dcbatipm/spine_smart/hardware/case-v3/README.txt

Spine Smart v3: корпус для базового этапа I

Для печати сначала экспортируйте bottom_v3.scad и lid_v3.scad в STL с помощью OpenSCAD.
Команды приведены в корневом README.md.

Размер корпуса в сборе: 70 x 58 x 9.6 мм.
Общий размер с проушинами: 80 x 58 x 9.6 мм.
Основание: 8.3 мм; крышка: 1.3 мм; внутренняя высота: 7.0 мм.

Номинальные размеры компонентов:
аккумулятор 25 x 35 x 6 мм,
TP4056 17.5 x 28 x 4 мм,
ESP32-C3 18 x 22.5 x 3.8 мм,
MPU-6050 16 x 21 x 2.8 мм,
вибромотор диаметром 10 мм, высотой 3 мм.

Что изменено:
- платы размещены рядом без наложений, с полной высотой макетов;
- аккумулятор с тонкой крепёжной лентой 0.2 мм имеет 0.8 мм запаса до крышки;
- четыре съёмные защёлки перенесены к свободным торцам;
- добавлена выемка под ноготь;
- проушины имеют сквозные замкнутые отверстия 26 x 2.8 мм;
- есть монтажные площадки и ограничители для плат, кольцо для вибромотора;
- есть отверстия под зарядку, USB ESP32 и ползунок выключателя;
- есть площадка для выключателя и мелких деталей, зазоры вокруг перегородки для проводов.

Как печатать:
1. Загрузите оба STL в слайсер. Масштаб 100%, единицы мм.
2. Корпус — дном на столе, открытой полостью вверх.
3. Крышка уже ориентирована: наружной плоскостью на столе, защёлками вверх.
4. Материал PETG. Сопло 0.4 мм, первый пробный экземпляр слоем 0.12-0.16 мм.
   Температуры и скорость возьмите из профиля своего принтера и пластика.
5. Посмотрите слои: все четыре язычка крышки должны печататься целиком.
   Оба STL — замкнутые цельные тела, но параметры слайсинга здесь не проверены.
6. После охлаждения снимите детали и примерьте пустую крышку.
   Открывайте от выемки под ноготь, освобождая защёлки постепенно.
7. Примерьте платы и аккумулятор без подключения питания; проверьте доступ
   к разъёмам и отсутствие давления на батарею до установки электроники.

Монтаж:
- Без вертикальных гребёнок и DuPont, согласно компоновке.
- Платы, датчик и мотор крепить тонкой монтажной лентой. Площадки под платы
  подняты на 0.6 мм, в макете заложено ещё 0.2 мм под ленту.
- Не выдумывались позиции винтовых отверстий покупных плат: их размеры не даны.
- Выключатель: выделенное место 12 x 6 x 5 мм — допущение, а не подтверждённый
  размер SS12D00. Проверьте конкретный переключатель до окончательной сборки.
- Центры и высоты USB-портов не измерены. Вырезы 12 x 5 мм сделаны
  предварительно; их совмещение и ход ползунка нужно проверить на реальных деталях.
  В SCAD есть параметры charge_x, esp_usb_x, usb_z, switch_slot_w и switch_z.

Проверено программно:
- OpenSCAD успешно построил оба STL.
- Каждая деталь состоит из одного связного замкнутого тела.
- Пересечения корпуса с макетами компонентов отсутствуют.
- Пересечение установленной крышки с корпусом отсутствует.
- Номинальные компоненты не пересекаются между собой и не касаются крышки.

Ограничение: это проверенный геометрически прототип под номинальные размеры компонентов.
Реальная печать, усилие защёлок, допуски принтера, прочность проушин и посадка
купленных деталей не проверены. Первый комплект нужен для примерки.
Для этапа II с N20 этот корпус не рассчитан.
