dcbatipm/spine_smart/docs/STATUS.md

# Состояние проекта — 26 октября 2026

Текущая прошивка v0.1.1: ESP32-C3 SuperMini, поддержка MPU6050 и MPU6500. На проверенном устройстве обнаружен MPU6500 (WHO_AM_I 0x70). Корпус — v3.

Подтверждены связь с датчиком, сохранение калибровки и поправки гироскопа после программного перезапуска, базовые переходы UPRIGHT → TILT_PENDING → SLOUCH и возврат UPRIGHT при выпрямлении. Мотор в этих проверках был выключен. Порог по умолчанию 15°, задержка 10 с, интервал предупреждений не менее 30 с. Точная задержка физически не измерена.

26 октября повторно прошли тесты логики на хосте (11/11), сборка обеих деталей в OpenSCAD 2021.01 и проверка геометрии: каждая деталь замкнута и связна, номинальные габариты компонентов не пересекаются.

Полная сборка прошивки в облаке успешно выполнена Arduino CLI 1.3.1 с Arduino-ESP32 3.3.2 для ESP32C3 Dev Module, USB CDC On Boot, 4 MB flash, Huge APP. Размер приложения 697016 байт (22% от 3145728), глобальные переменные 24800 байт (7% от 327680). Проверенные исходники соответствуют коммиту 53e82f1. Запись на устройство не выполнялась.

Следующие физические проверки: холодный запуск, посадка в напечатанном корпусе, схема моторного ключа и вибрация, BLE с телефоном, аккумулятор и зарядка, ложные срабатывания при обычной активности. После изменения крепления или человека повторить калибровку.

Мотор подключается через внешний транзисторный ключ с проверенной распиновкой и защитным диодом, не напрямую к GPIO. Перед проверкой мотора сверить питание. Облако не имеет прямого доступа к USB-плате на ноутбуке.

Публичный репозиторий содержит исходники и документацию. Частная переписка, телеметрия, дампы памяти, исходные архивы и история частного рабочего каталога сюда не включены.
