dcbatipm/spine_smart/bom/BOM.md

# Bill of Materials (BOM) — Спецификация компонентов
**Проект:** Носимое устройство для поддержания правильной осанки (dfp2026-b01-508)

---

## 1. Этап I: Электроника базового мониторинга и тактильного отклика

| № | Позиция / Компонент | Описание и характеристики | Кол-во | Назначение |
|---|---|---|---|---|
| 1 | **ESP32-C3 SuperMini** | МК 32-bit RISC-V, 160 МГц, встроенный 2.4 GHz Wi-Fi / BLE 5.0 | 1 шт. | Сбор данных, BLE-стек, логика FSM |
| 2 | **MPU-6050 (GY-521)** | 6-осевой IMU (акселерометр + гироскоп), шина I2C | 1 шт. | Измерение наклона грудного отдела позвоночника |
| 3 | **Вибромотор 1027** | Плоский дисковый ERM вибромотор (диаметр 10 мм, 3 В) | 2 шт. | Вибротактильное напоминание (1 шт. запас) |
| 4 | **Транзистор 2N2222 / SS8050** | Биполярный NPN-транзистор (SOT-23 / TO-92) | 2 шт. | Силовой ключ управления вибромотором от GPIO |
| 5 | **Диод 1N4148** | Импульсный диод (обратный диод для защиты от индуктивных выбросов) | 2 шт. | Защита транзистора при отключении мотора |
| 6 | **Резисторы 1 кОм и 10 кОм** | Резисторы 0.125 Вт / SMD 0805 | по 2 шт.| Базовое ограничение и подтяжка к земле (pull-down) |
| 7 | **Li-Pol аккумулятор 3.7 В** | Ёмкость 500–650 мА·ч (типоразмер 602535 / 702535) с платой защиты | 1 шт. | Автономное питание нательного модуля |
| 8 | **Модуль заряда TP4056 Type-C** | Контроллер заряда с цепью защиты аккумулятора | 1 шт. | Зарядка АКБ от стандартного разъёма Type-C |
| 9 | **Ползунковый переключатель SS12D00** | Миниатюрный тумблер включения питания (ON/OFF) | 1 шт. | Разрыв цепи питания аккумулятора |

---

## 2. Корпус, швейная оснастка и механика (Этап I)

| № | Позиция / Материал | Описание и характеристики | Кол-во | Назначение |
|---|---|---|---|---|
| 10 | **Ременная стропа 25 мм** | Плотная полипропиленовая / нейлоновая лента | 2.5 м | Формирование плечевой петли-«восьмёрки» |
| 11 | **Пряжка двухщелевая (ladder-lock) 25 мм** | Пластиковая фурнитура для ручной подгонки длины | 2 шт. | Первичная регулировка посадки под рост и плечи |
| 12 | **Фастекс (защёлка) 25 мм** | Быстроразъёмный пластиковый замок | 1 шт. | Удобное надевание/снятие и экстренный сброс |
| 13 | **Филамент PETG / PLA+** | Износостойкий пластик для 3D-печати | ~150 г | Печать корпуса межлопаточного блока и крышки |
| 14 | **Винты и вплавляемые резьбовые втулки M2 / M2.5** | Латунные втулки + винты потай/полукруг | 4 комплекта | Разборная фиксация крышки нательного корпуса |

---

## 3. Этап II: Модуль активной механической коррекции (расширение)

| № | Позиция / Компонент | Описание и характеристики | Кол-во | Назначение |
|---|---|---|---|---|
| 15 | **Микромотор-редуктор N20** | 6–12 В, червячный самотормозящийся редуктор (низкие обороты) | 1 шт. | Моторизованное натяжение плечевой стропы |
| 16 | **Драйвер двигателя DRV8833 / DRV8834** | Двухканальный H-мост / драйвер ШД с токовым контролем | 1 шт. | Силовое управление натяжителем |
| 17 | **Тензорезистивный датчик / шунт тока** | Шунт измерения тока драйвера или тензолента стропы | 1 шт. | Замкнутый контур обратной связи по усилию (отсечка) |
