dcbatipm/spine_smart/(list of files, cad)

Other CAD files:
hardware/case-v3/bottom_v3.scad
hardware/case-v3/lid_v3.scad
