dcbatipm/spine_smart/docs/Schemes_for_project.pdf

# Схемы аппаратного комплекса

## Умный корректор осанки (Этап I и II)

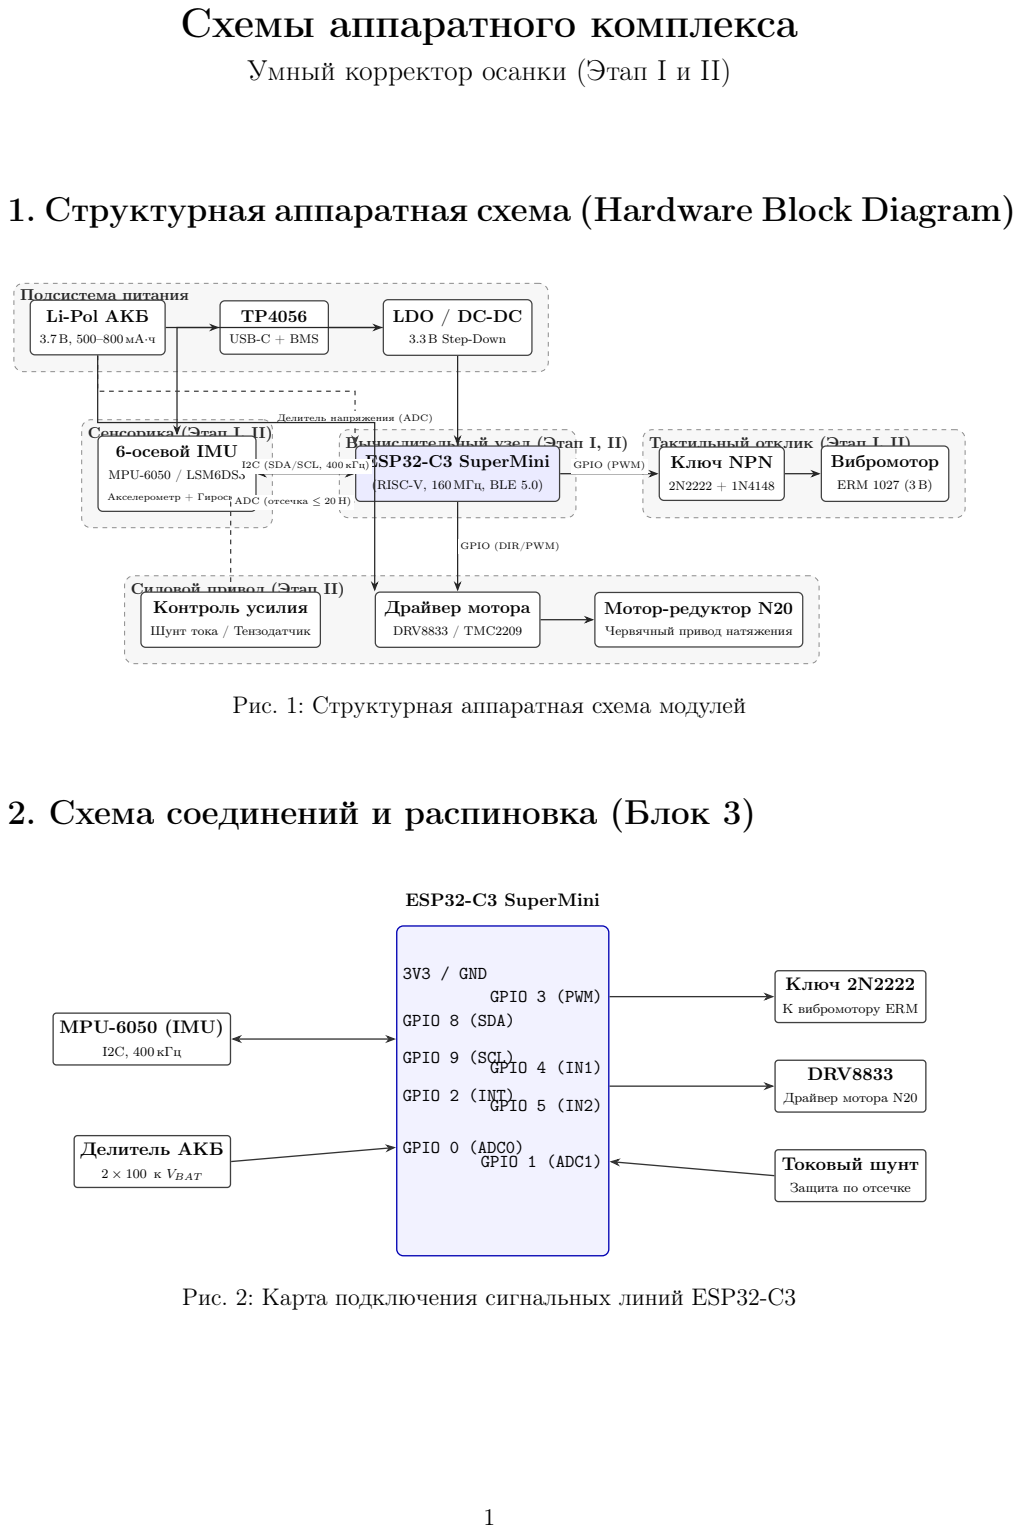
[picture p6: page 1]
Сенсорика (Этап I, II); Вычислительный узел (Этап I, II); Тактильный отклик (Этап I, II); ESP32-C3 SuperMini; 6-осевой IMU; MPU-6050 / LSM6DS3; Акселерометр + Гироскоп; Ключ NPN; Вибромотор; ERM 1027 (3 В); 3.3 В Step-Down; USB-C + BMS; Драйвер мотора; DRV8833 / TMC2209; Мотор-редуктор N20; I2C (SDA/SCL, 400 кГц); GPIO (PWM); ADC (отсечка ≤ 20 Н); 3V3 / GND; GPIO 8 (SDA); GPIO 9 (SCL); GPIO 2 (INT); GPIO 0 (ADC0); GPIO 3 (PWM); GPIO 4 (IN1); GPIO 5 (IN2); GPIO 1 (ADC1); MPU-6050 (IMU)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

1. Структурная аппаратная схема (Hardware Block Diagram)

Подсистема питания
Li-Pol АКБ

LDO / DC-DC

Делитель напряжения (ADC)

(RISC-V, 160 МГц, BLE 5.0)

GPIO (DIR/PWM)

Силовой привод (Этап II)
Контроль усилия

Шунт тока / Тензодатчик

Червячный привод натяжения

Рис. 1: Структурная аппаратная схема модулей

2. Схема соединений и распиновка (Блок 3)

Защита по отсечке

Рис. 2: Карта подключения сигнальных линий ESP32-C3
