dcbatipm/spine_smart/(commit log)

2026-09-15 Add Bill of Materials for posture correction device
    Added a comprehensive Bill of Materials (BOM) for the wearable posture correction device project, detailing components, specifications, and quantities across multiple stages.
2026-10-02 Add files via upload
    Схема подключения к ESP и структурно аппаратная схема
2026-10-26 Add firmware v0.1.1, case v3 sources and current verification status
2026-10-26 Record successful ESP32-C3 build with Arduino-ESP32 3.3.2
